Yourigh/BrimEffect_ESP32/README.md

# BrimEffect_ESP32
 ESP32 board with interface for WS2812 LED strip, connected MIC and IR remote receiver, including FW and 3D prited box
 
# 3D prited box
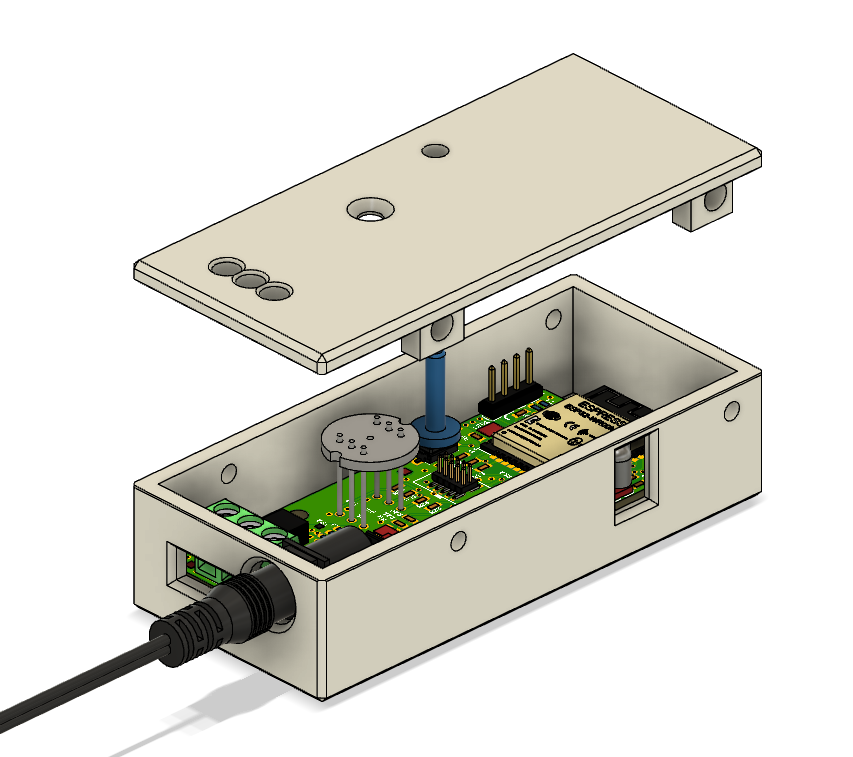
[picture p1: Mechanical/PCBAwBOX.png]
3D model
