Yourigh/BrimEffect_ESP32/Electrical/3 - Gerbers/GerberFiles.png_Combined_Bottom.png

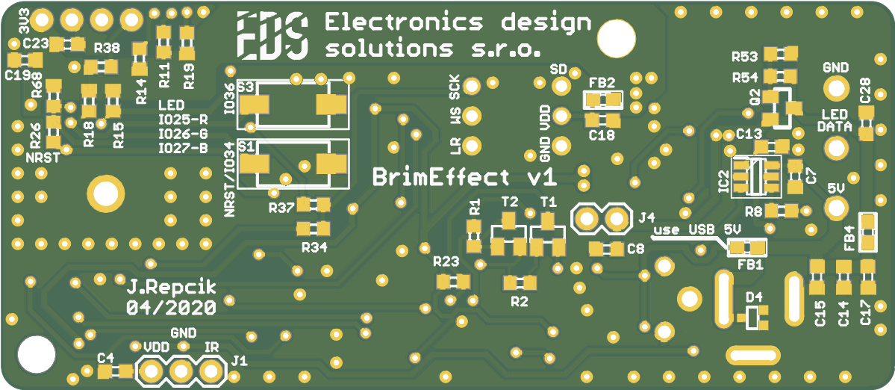
Electrical/3 - Gerbers/GerberFiles.png_Combined_Bottom.png
