Yourigh/BrimEffect_ESP32/Electrical/3 - Gerbers/GerberFiles.png_Combined_Top.png

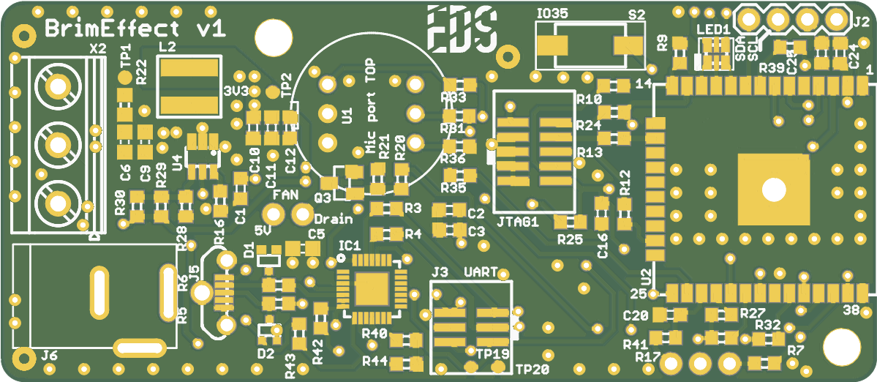
Electrical/3 - Gerbers/GerberFiles.png_Combined_Top.png
