Yourigh/BrimEffect_ESP32/Mechanical/Sub-models/button.webp

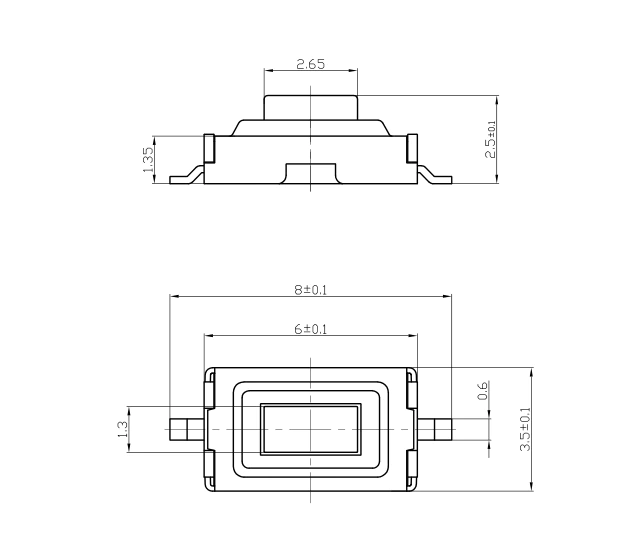
Mechanical/Sub-models/button.webp
