Yourigh/BrimEffect_ESP32/Mechanical/Sub-models/Mic Module INMP441/BOT.png

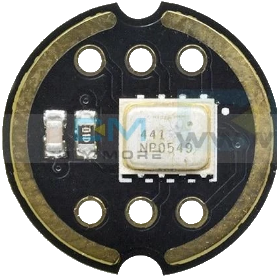
Mechanical/Sub-models/Mic Module INMP441/BOT.png
