Yourigh/BrimEffect_ESP32/Mechanical/Sub-models/Mic Module INMP441/INMP441_module v4.png

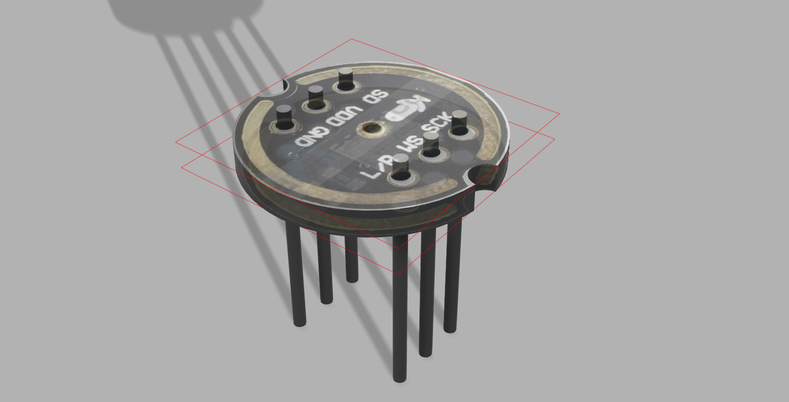
Mechanical/Sub-models/Mic Module INMP441/INMP441_module v4.png
