Yourigh/BrimEffect_ESP32/Mechanical/Sub-models/Mic Module INMP441/Mic_module_dimensions.png

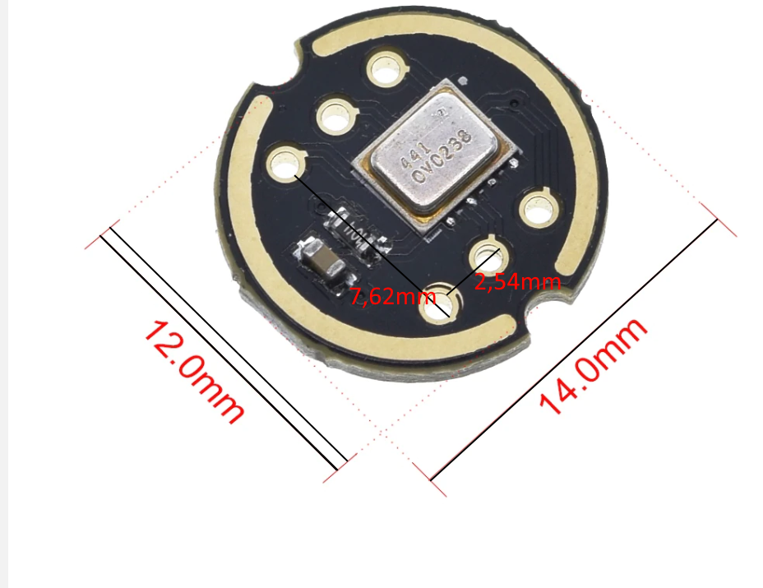
Mechanical/Sub-models/Mic Module INMP441/Mic_module_dimensions.png
