Yourigh/BrimEffect_ESP32/Mechanical/Sub-models/Thread_inserts_M3x4,6used.jpg

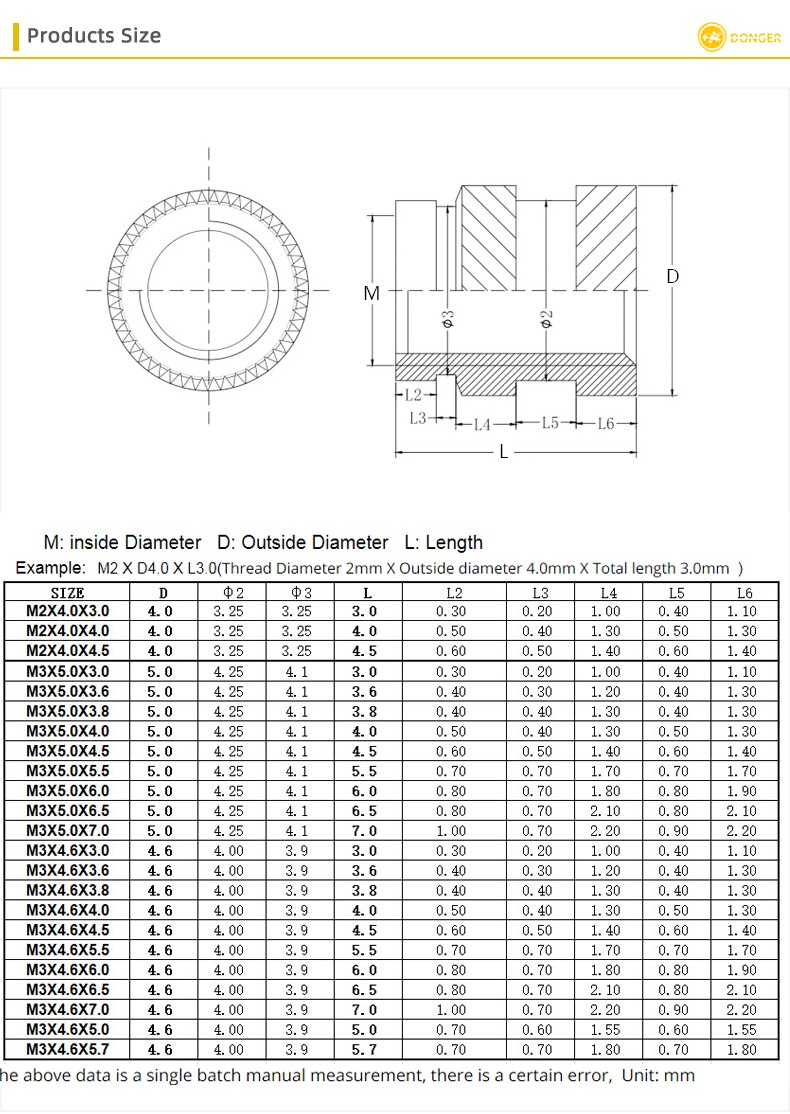
Mechanical/Sub-models/Thread_inserts_M3x4,6used.jpg
