Yourigh/BrimEffect_ESP32/Mechanical/Sub-models/tsop-infrared-receiver-1.snapshot.1/TSOP.jpg

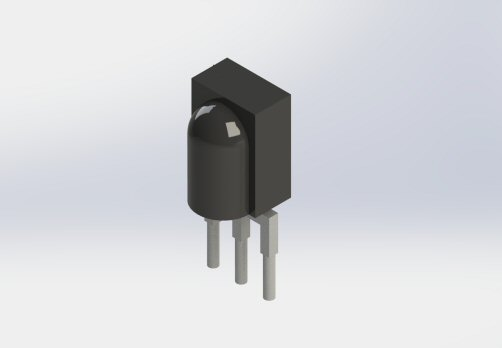
Mechanical/Sub-models/tsop-infrared-receiver-1.snapshot.1/TSOP.jpg
