Yourigh/BrimEffect_ESP32/Mechanical/Sub-models/jtagconn-m50-3610542_asm.stp

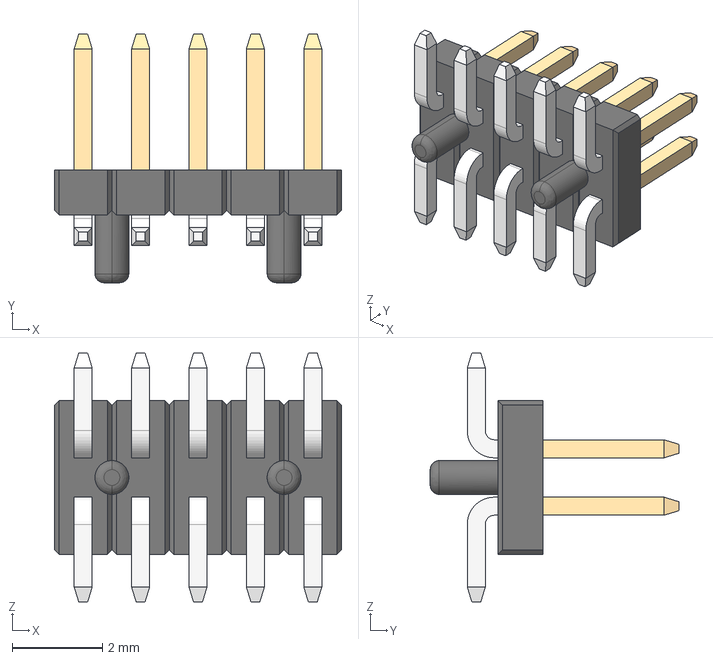
[picture p11: CAD file, 2020-04-05]
Mechanical/Sub-models/jtagconn-m50-3610542_asm.stp
6.35 x 5.50 x 5.50 mm
M50-36105_MOULD
M50-361_CONTACT x 10
