Yourigh/BrimEffect_ESP32/Mechanical/200408_3D_print_export_v22/Box1 v1.stl

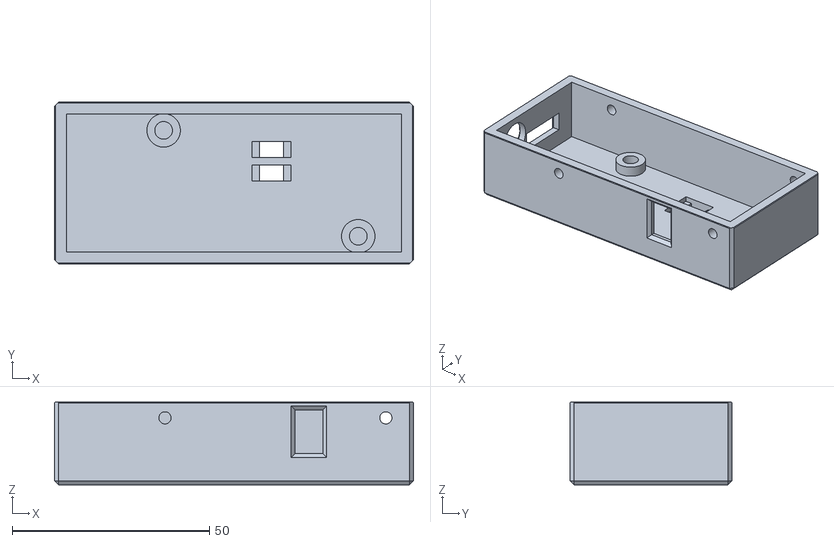
[picture p12: CAD file, 2020-04-08]
Mechanical/200408_3D_print_export_v22/Box1 v1.stl
91.0 x 41.0 x 21.0
