Yourigh/BrimEffect_ESP32/Mechanical/Sub-models/DCJack_5.5x2.1_cable.STEP

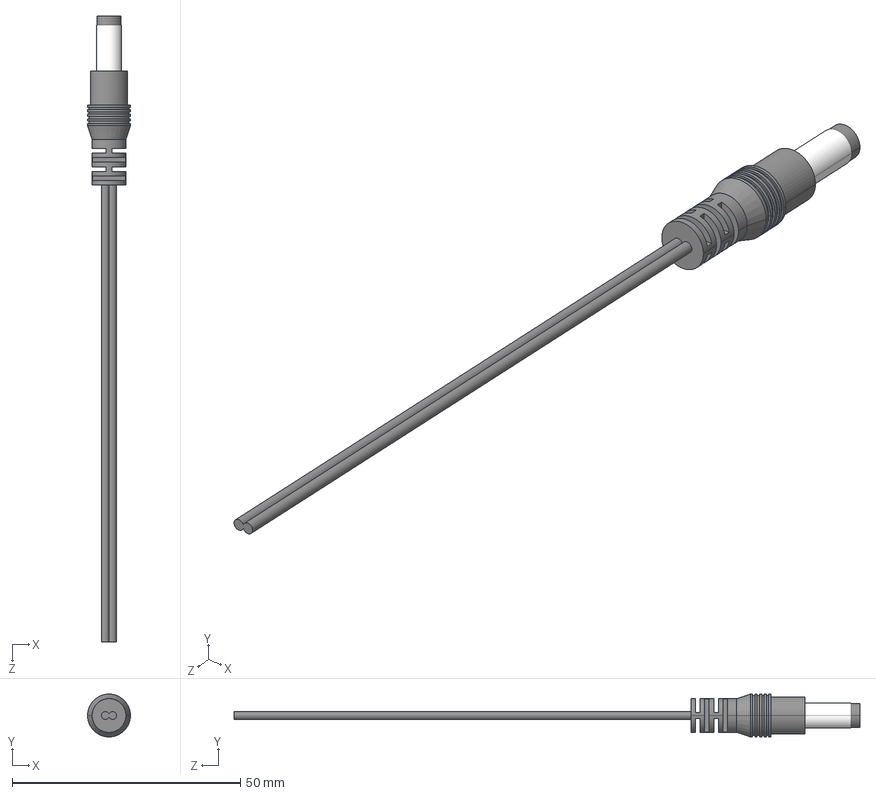
[picture p13: CAD file, 2020-04-07]
Mechanical/Sub-models/DCJack_5.5x2.1_cable.STEP
9.40 x 9.40 x 137.0 mm
