Yourigh/BrimEffect_ESP32/Mechanical/Sub-models/Mic Module INMP441/INMP441_module v4.step

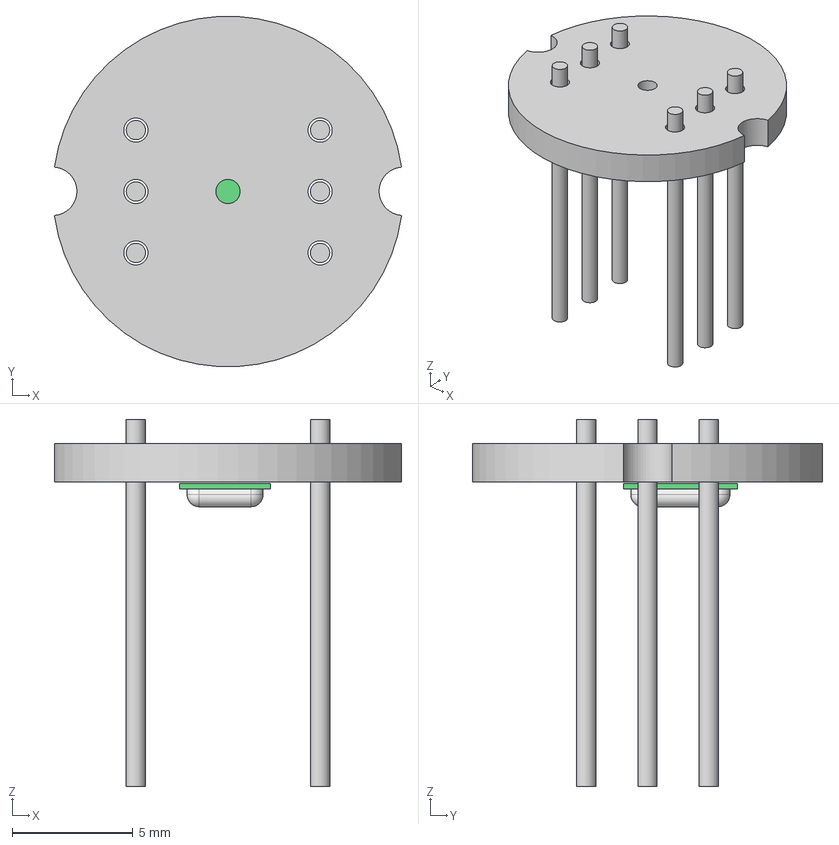
[picture p14: CAD file, 2020-04-24]
Mechanical/Sub-models/Mic Module INMP441/INMP441_module v4.step
14.4 x 14.5 x 15.2 mm
Product
pins
