Yourigh/BrimEffect_ESP32/Mechanical/Sub-models/tsop-infrared-receiver-1.snapshot.1/TSOP.STEP

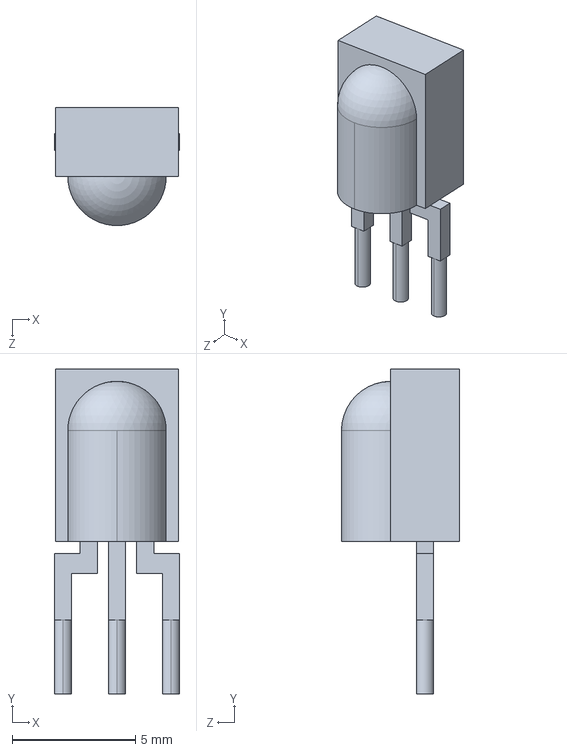
[picture p15: CAD file, 2020-04-05]
Mechanical/Sub-models/tsop-infrared-receiver-1.snapshot.1/TSOP.STEP
5.08 x 13.2 x 4.80 mm
