Yourigh/BrimEffect_ESP32/Mechanical/200408_3D_print_export_v22/Lid v1.stl

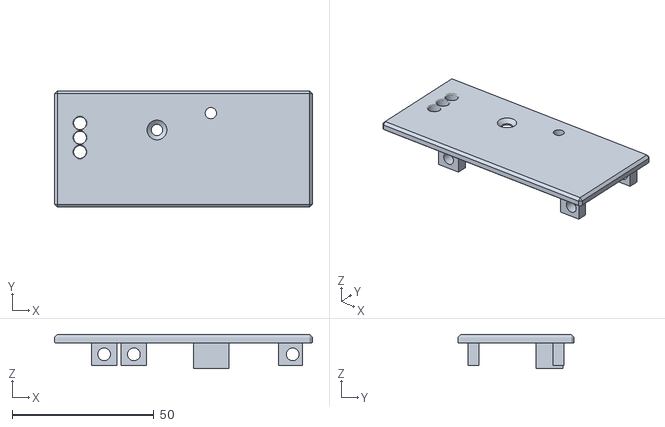
[picture p16: CAD file, 2020-04-08]
Mechanical/200408_3D_print_export_v22/Lid v1.stl
91.0 x 41.0 x 12.0
