Yourigh/BrimEffect_ESP32/Mechanical/Sub-models/pxc_1729131_07_MKDSN-1-5-3-5-08_3D.stp

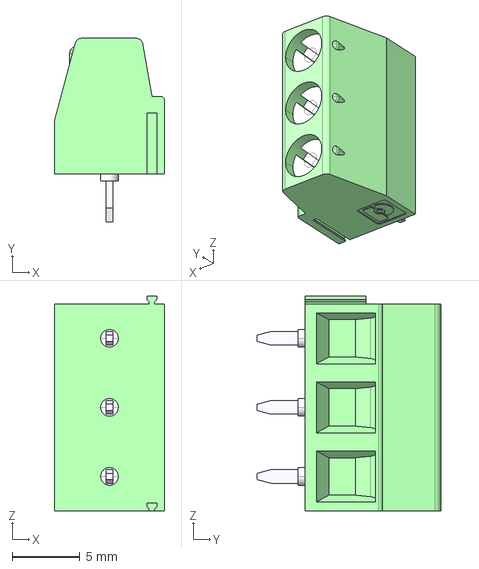
[picture p17: CAD file, 2020-04-05]
Mechanical/Sub-models/pxc_1729131_07_MKDSN-1-5-3-5-08_3D.stp
8.10 x 13.5 x 15.8 mm
