Yourigh/BrimEffect_ESP32/Mechanical/200408_3D_print_export_v22/Btn act top v1.stl

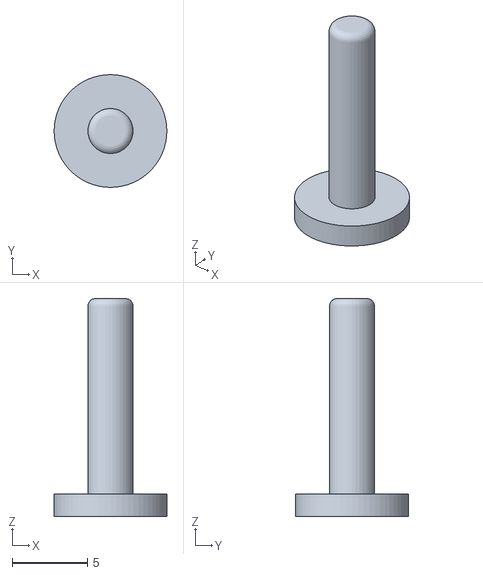
[picture p18: CAD file, 2020-04-08]
Mechanical/200408_3D_print_export_v22/Btn act top v1.stl
7.50 x 7.50 x 14.5
