Yourigh/BrimEffect_ESP32/Mechanical/Sub-models/Mic Module INMP441/mic-INMP441.stp

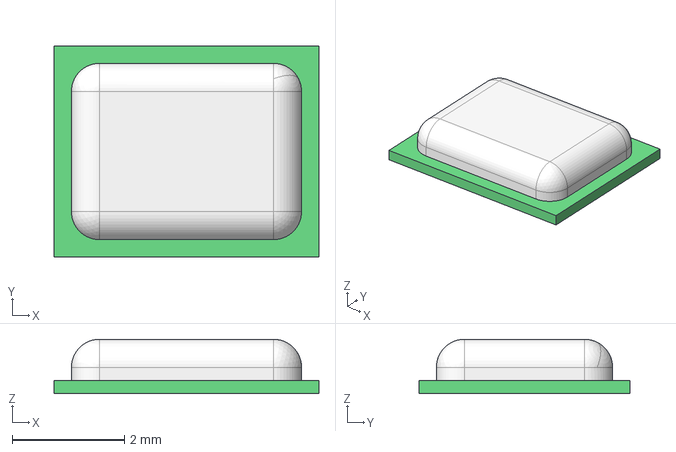
[picture p19: CAD file, 2020-04-05]
Mechanical/Sub-models/Mic Module INMP441/mic-INMP441.stp
4.72 x 3.76 x 0.97 mm
