Yourigh/BrimEffect_ESP32/Mechanical/200408_3D_print_export_v22/2PCS_Button actuator bottom v5.stl

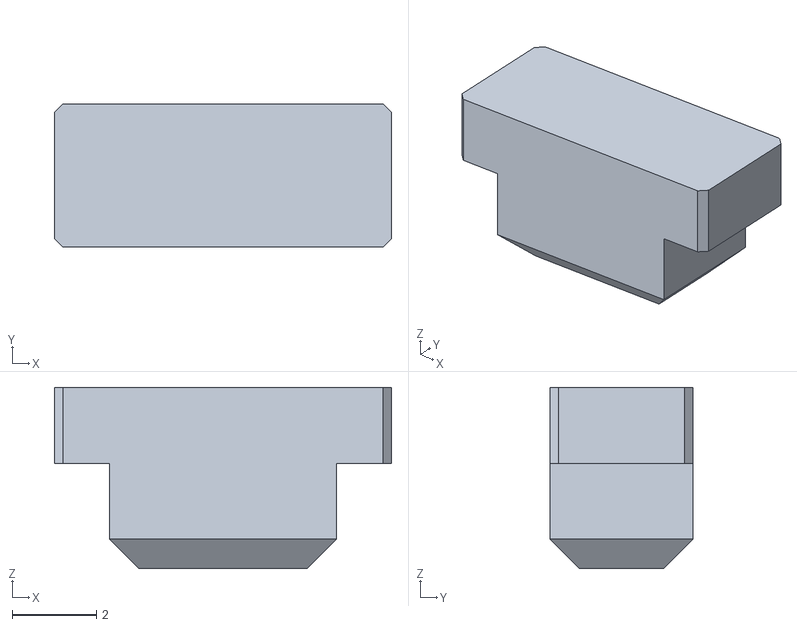
[picture p20: CAD file, 2020-04-08]
Mechanical/200408_3D_print_export_v22/2PCS_Button actuator bottom v5.stl
8.00 x 3.40 x 4.30
