Yourigh/BrimEffect_ESP32/Mechanical/Sub-models/UARTconn-FTSH-103-01-F-DV.stp

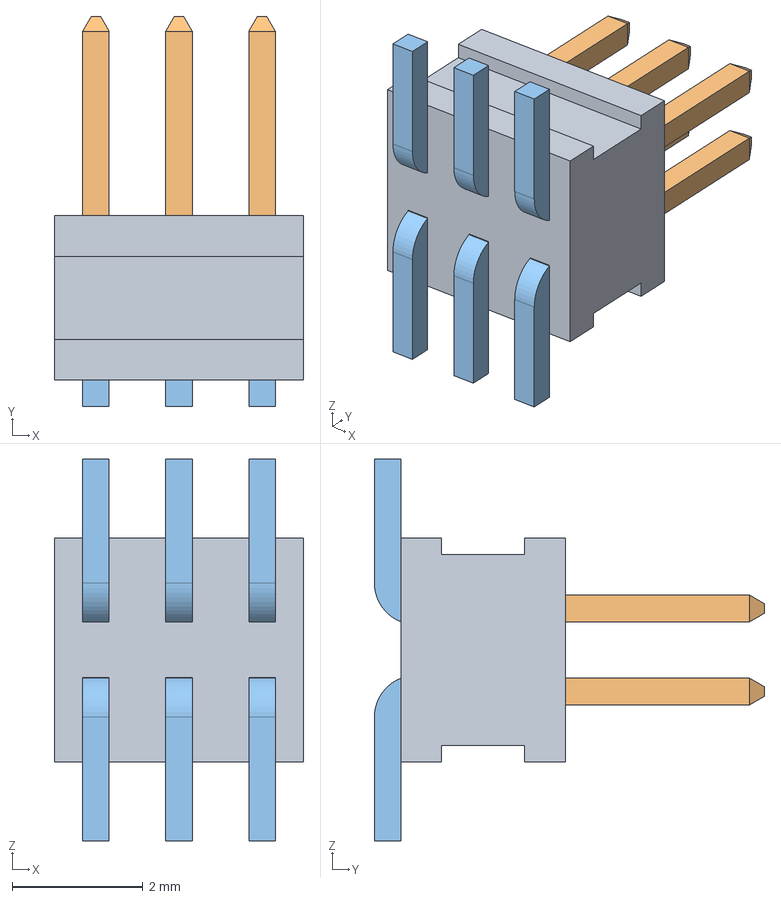
[picture p21: CAD file, 2020-04-05]
Mechanical/Sub-models/UARTconn-FTSH-103-01-F-DV.stp
3.81 x 5.97 x 5.84 mm
_FTSH-103-01-F-DV_body
_FTSH-103-01-F-DV_pins1
_FTSH-103-01-F-DV_pins2
