Yourigh/BrimEffect_ESP32/Mechanical/Sub-models/USB-micro-vert-molex-1051330001.stp

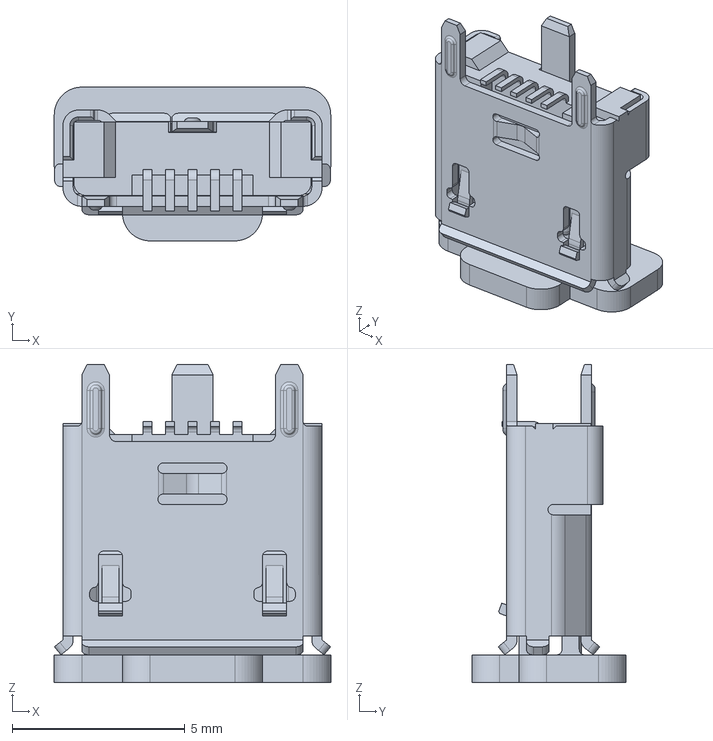
[picture p22: CAD file, 2020-04-05]
Mechanical/Sub-models/USB-micro-vert-molex-1051330001.stp
8.00 x 4.45 x 9.20 mm
