Yourigh/BrimEffect_ESP32/Mechanical/Sub-models/DCjack_CUI_DEVICES_PJ-002A.step

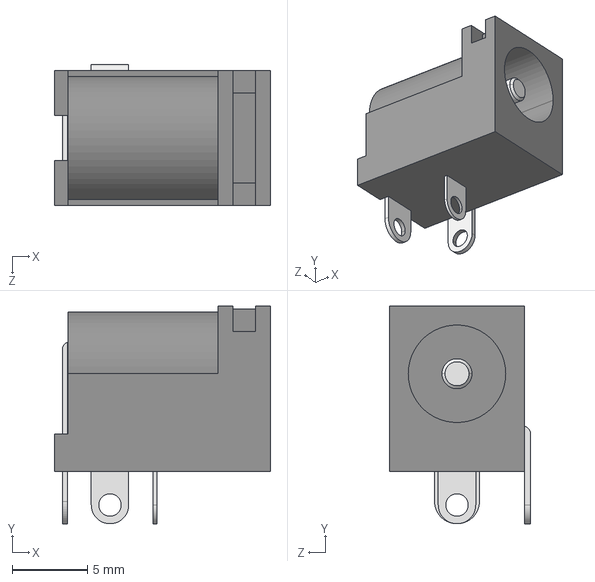
[picture p23: CAD file, 2020-04-05]
Mechanical/Sub-models/DCjack_CUI_DEVICES_PJ-002A.step
14.4 x 14.5 x 9.40 mm
