Yourigh/BrimEffect_ESP32/(list of files, cad)

Other CAD files:
Mechanical/Sub-models/Mic Module INMP441/INMP441_module_rigid v1.step
Mechanical/Sub-models/Mic Module INMP441/INMP441_module v4.f3z
Mechanical/Sub-models/USB-micro-vert-molex-1051330001-e v1.f3d
Mechanical/Sub-models/switch PTS636SK25FSMTRLFS v2.f3d
Mechanical/Sub-models/tsop-infrared-receiver-1.snapshot.1/IR receiver TSOP v2.f3d
Mechanical/Sub-models/tsop-infrared-receiver-1.snapshot.1/TSOP.SLDPRT
