Yourigh/BrimEffect_ESP32/(threads)

Thread 1 (2020-06-26):

An idea

LovelyMengstar, 2020-06-26:
Hello,  you use this project too.(audio-reactive-led-strip)
I think INMP441 costs too much, I want to use SPK 1638Lm4H-B.(https://dtsheet.com/doc/1267573/spk1638lm4h-b)
But I don't know how to draw chematics. Can you help me？Also use esp32.
