Yourigh/BrimEffect_ESP32/Electrical/1 - Schematics/200414_sch.pdf

A

A

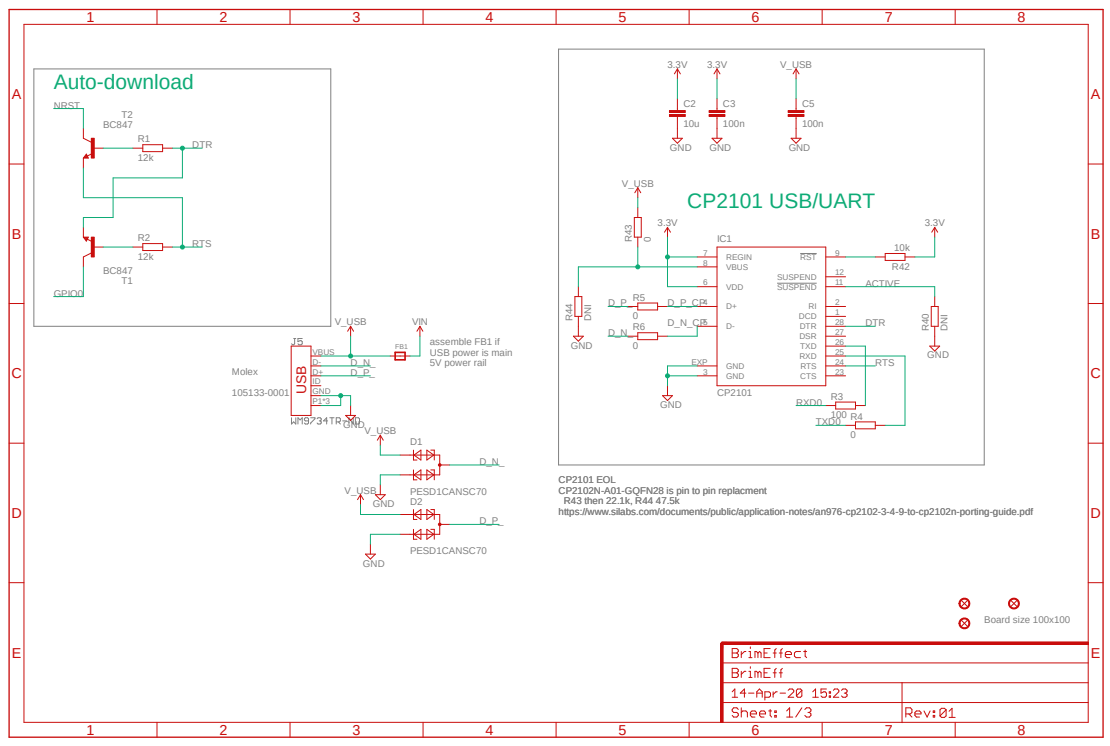
[picture p24: page 1]

VIN
assemble FB1 if
USB power is main
5V power rail

CP2101 EOL
CP2102N-A01-GQFN28 is pin to pin replacment
R43 then 22.1k, R44 47.5k
https://www.silabs.com/documents/public/application-notes/an976-cp2102-3-4-9-to-cp2102n-porting-guide.pdf

# POWER

R22R²⁸ | R²⁹ | R³⁰

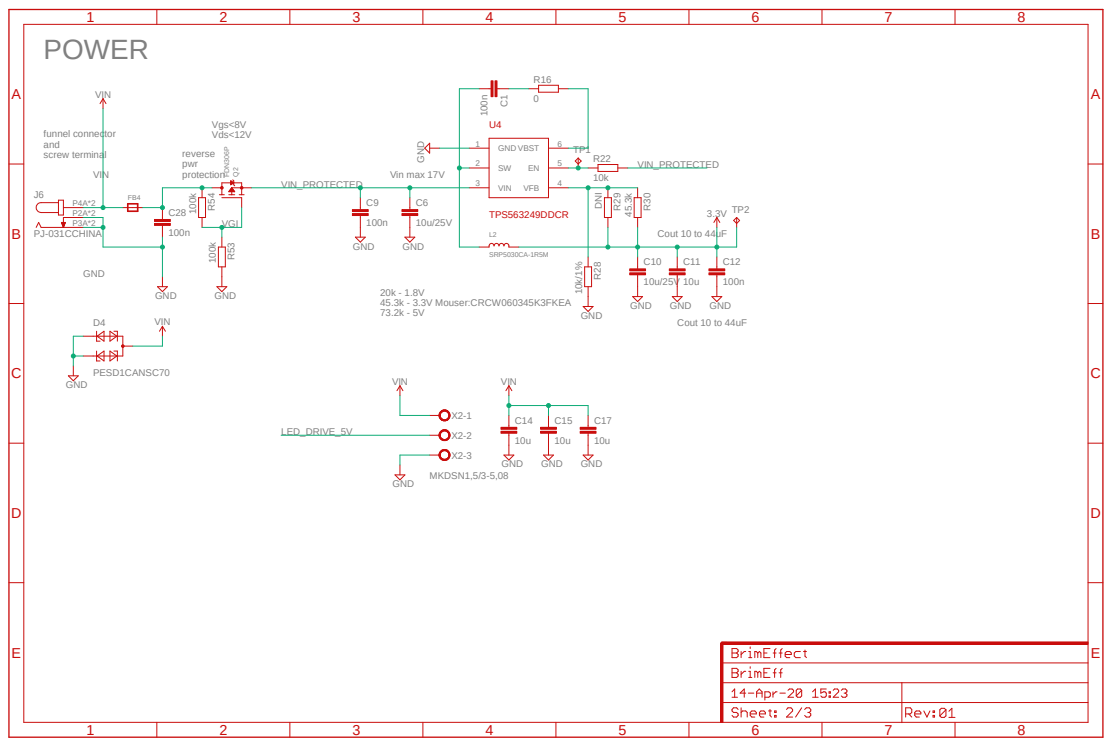
[picture p25: page 2]

A

A

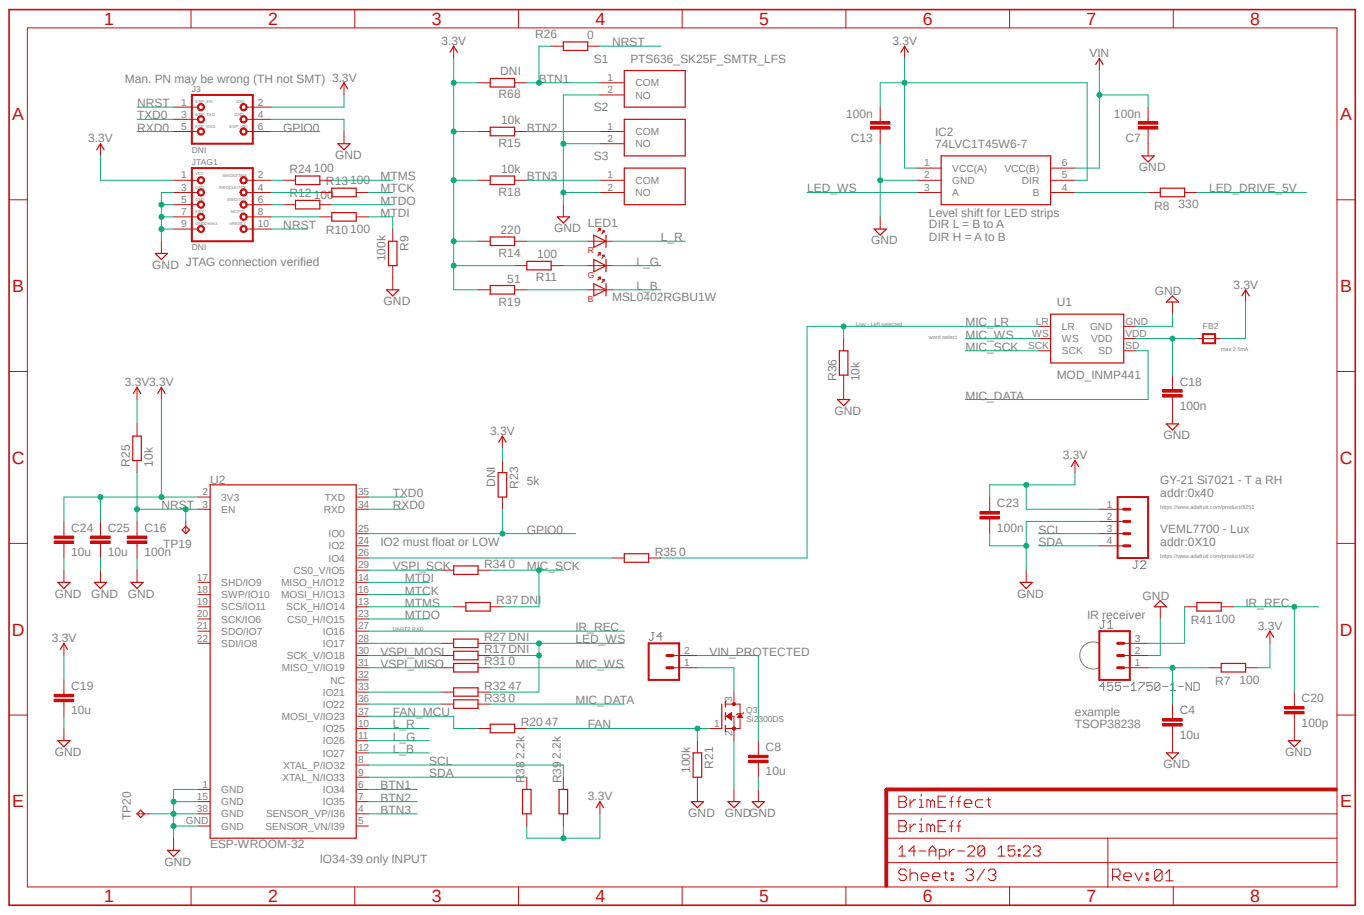
[picture p26: page 3]

Man. PN may be wrong (TH not SMT)
NRST
TXD0
RXD0

https://www.adafruit.com/product/3251 GY-21 Si7021 - T a RH
addr:0x40

https://www.adafruit.com/product/4162
