Yourigh/BrimEffect_ESP32/Electrical/5 - CAD project/BrimEff.brd

## EAGLE design Electrical/5 - CAD project/BrimEff.brd (2020-06-14)

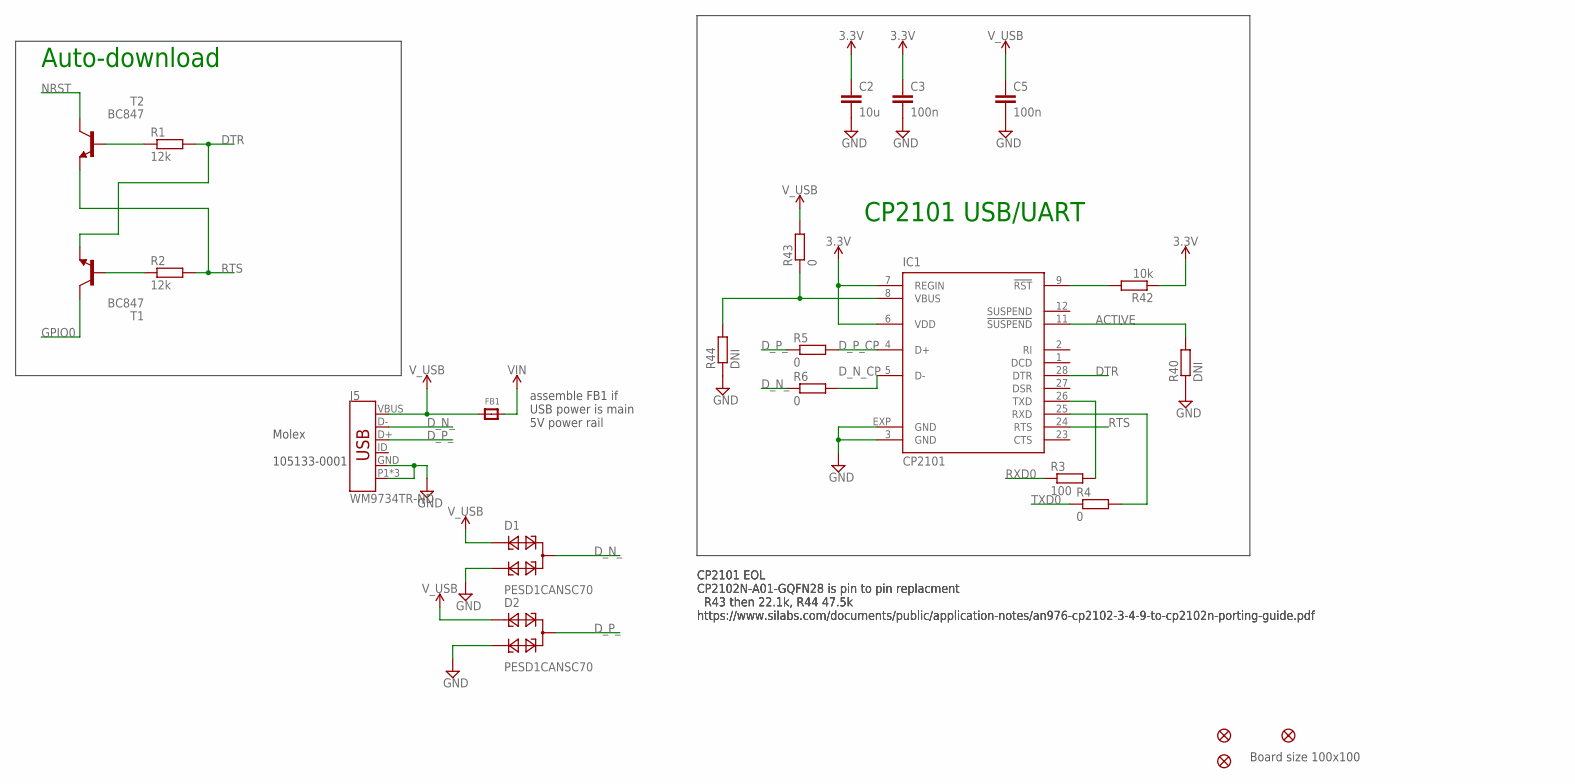
[picture p27: schematic BrimEff.sch, sheet 1]

Parts:
C2: 10u; C0603K; PARTNO GRM188R61A106KE69J
C3, C5: 100n; C0603K; PARTNO CC0603KRX7R8BB104
D1, D2: PESD1CANSC70; SOT323-R; PARTNO PESD1CAN-UX
FB1: FERRITE; 0603; PARTNO BLM18PG121SN1D
FID1, FID2, FID4: FIDUCIAL""; FIDUCIAL_1MM
IC1: CP2101; MLP28; PARTNO CP2101-GM
J5: WM9734TR-ND; USB-B-MICRO-SMD_VERT; PARTNO 105133-0001
R1, R2: 12k; R0603; PARTNO RC0603FR-0712KL
R3: 100; R0603; PARTNO CRCW0603100RFKEAC
R4, R5, R6, R43: 0; R0603; PARTNO CRCW06030000Z0EAC
R40, R44: DNI; R0603; PARTNO CRCW06030000Z0EAC
R42: 10k; R0603; PARTNO CRCW060310K0JNEAC
T1, T2: BC847; SOT23; PARTNO BC847A-TP

Connections:
3.3V: C2.1, C3.1, IC1.6 (VDD), IC1.7 (REGIN), R42.1; also elsewhere on the board
ACTIVE: IC1.11 (!SUSPEND), R40.2
DTR: IC1.28 (DTR), R1.2, T1.2 (E)
D_N_: D1.3, J5.D-, R6.1
D_N_CP: IC1.5 (D-), R6.2
D_P_: D2.3, J5.D+, R5.1
D_P_CP: IC1.4 (D+), R5.2
GND: C2.2, C3.2, C5.2, D1.2, D2.2, IC1.3 (GND), IC1.EXP (GND), J5.GND, J5.P1 (SHIELD), J5.P2 (SHIELD), J5.P3 (SHIELD), R40.1, R44.1; also elsewhere on the board
GPIO0: T1.3 (C); also elsewhere on the board
unnamed: R1.1, T2.1 (B)
unnamed: R2.1, T1.1 (B)
unnamed: IC1.9 (!RST), R42.2
unnamed: IC1.8 (VBUS), R43.1, R44.2
NRST: T2.3 (C); also elsewhere on the board
RTS: IC1.24 (RTS), R2.2, T2.2 (E)
RXD0: R3.1; also elsewhere on the board
RXD0_CP2101IN: IC1.26 (TXD), R3.2
TXD0: R4.1; also elsewhere on the board
TXD0_CP2101: IC1.25 (RXD), R4.2
VIN: FB1.2; also elsewhere on the board
V_USB: C5.1, D1.1, D2.1, FB1.1, J5.VBUS, R43.2

Notes on the sheet:
CP2101 USB/UART
Auto-download
Board size 100x100
Molex 105133-0001
CP2101 EOL CP2102N-A01-GQFN28 is pin to pin replacment R43 then 22.1k, R44 47.5k https://www.silabs.com/documents/public/application-notes/an976-cp2102-3-4-9-to-cp2102n-porting-guide.pdf
assemble FB1 if USB power is main 5V power rail

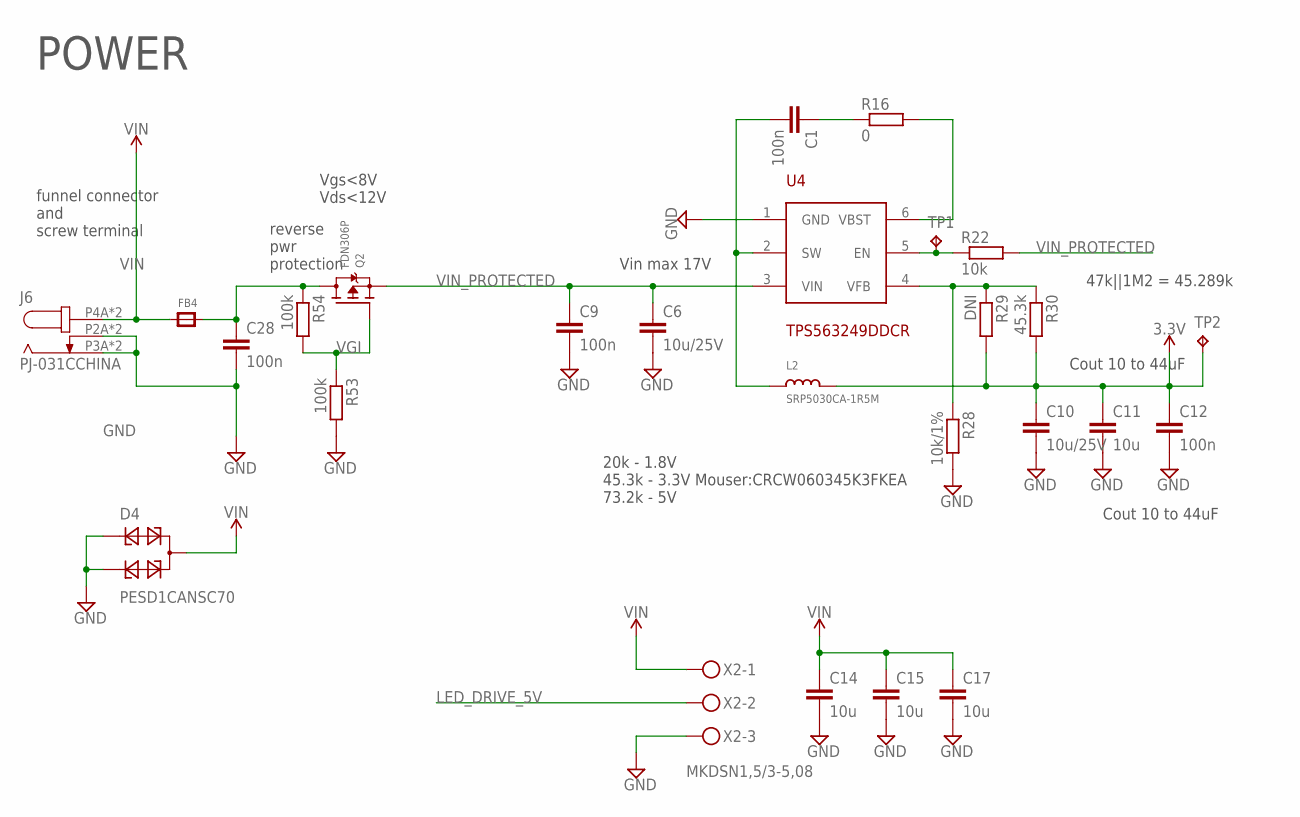
[picture p28: schematic BrimEff.sch, sheet 2]

Parts:
C1, C9, C12, C28: 100n; C0603K; PARTNO CC0603KRX7R8BB104
C6, C10: 10u/25V; C0603K; PARTNO GRM188R61E106KA73J
C11, C14, C15, C17: 10u; C0603K; PARTNO GRM188R61A106KE69J
D4: PESD1CANSC70; SOT323-R; PARTNO PESD1CAN-UX
FB4: FERRITE; 0603; PARTNO BLM18PG121SN1D
J6: PJ-031CCHINA; DC-005_5.5X2.1MM_JACK
L2: SRP5030CA-1R5M; SRP5030CA; PARTNO SRP5030CA-1R5M
Q2: FDN306P; SOT23-WIDE; PARTNO FDN306P
R16: 0; R0603; PARTNO CRCW06030000Z0EAC
R22: 10k; R0603; PARTNO CRCW060310K0JNEAC
R28: 10k/1%; R0603; PARTNO RN73R1JTTD1002D25
R29: DNI; R0603
R30: 45.3k; R0603; PARTNO ERJ-PB3D4532V
R53, R54: 100k; R0603; PARTNO CRCW0603100KFKEAC
TP1, TP2: TPTP10R; TP10R
U4: TPS563249DDCR; SOT23-6; PARTNO TPS563249DDCR
X2: MKDSN1,5/3-5,08

Connections:
3.3V: C10.1, C11.1, C12.1, L2.P$2 (2), R29.2, R30.2, TP2.TP; also elsewhere on the board
GND: C6.2, C9.2, C10.2, C11.2, C12.2, C14.2, C15.2, C17.2, C28.2, D4.1, D4.2, J6.P2A (3), J6.P2B (3), J6.P3A (2), J6.P3B (2), R28.2, R53.2, U4.1 (GND), X2.3; also elsewhere on the board
LED_DRIVE_5V: X2.2; also elsewhere on the board
unnamed: C1.1, R16.1
unnamed: C28.1, FB4.2, Q2.3 (D), R54.1
unnamed: R16.2, U4.6 (VBST)
unnamed: C1.2, L2.P$1 (1), U4.2 (SW)
unnamed: R22.1, TP1.TP, U4.5 (EN)
unnamed: R28.1, R29.1, R30.1, U4.4 (VFB)
VGI: Q2.1 (G), R53.1, R54.2
VIN: C14.1, C15.1, C17.1, D4.3, FB4.1, J6.P4A (1), J6.P4B (1), X2.1; also elsewhere on the board
VIN_PROTECTED: C6.1, C9.1, Q2.2 (S), R22.2, U4.3 (VIN); also elsewhere on the board

Notes on the sheet:
POWER
20k - 1.8V 45.3k - 3.3V Mouser:CRCW060345K3FKEA 73.2k - 5V
Cout 10 to 44uF
reverse pwr protection
Vgs<8V Vds<12V
Vin max 17V
funnel connector and screw terminal
47k||1M2 = 45.289k

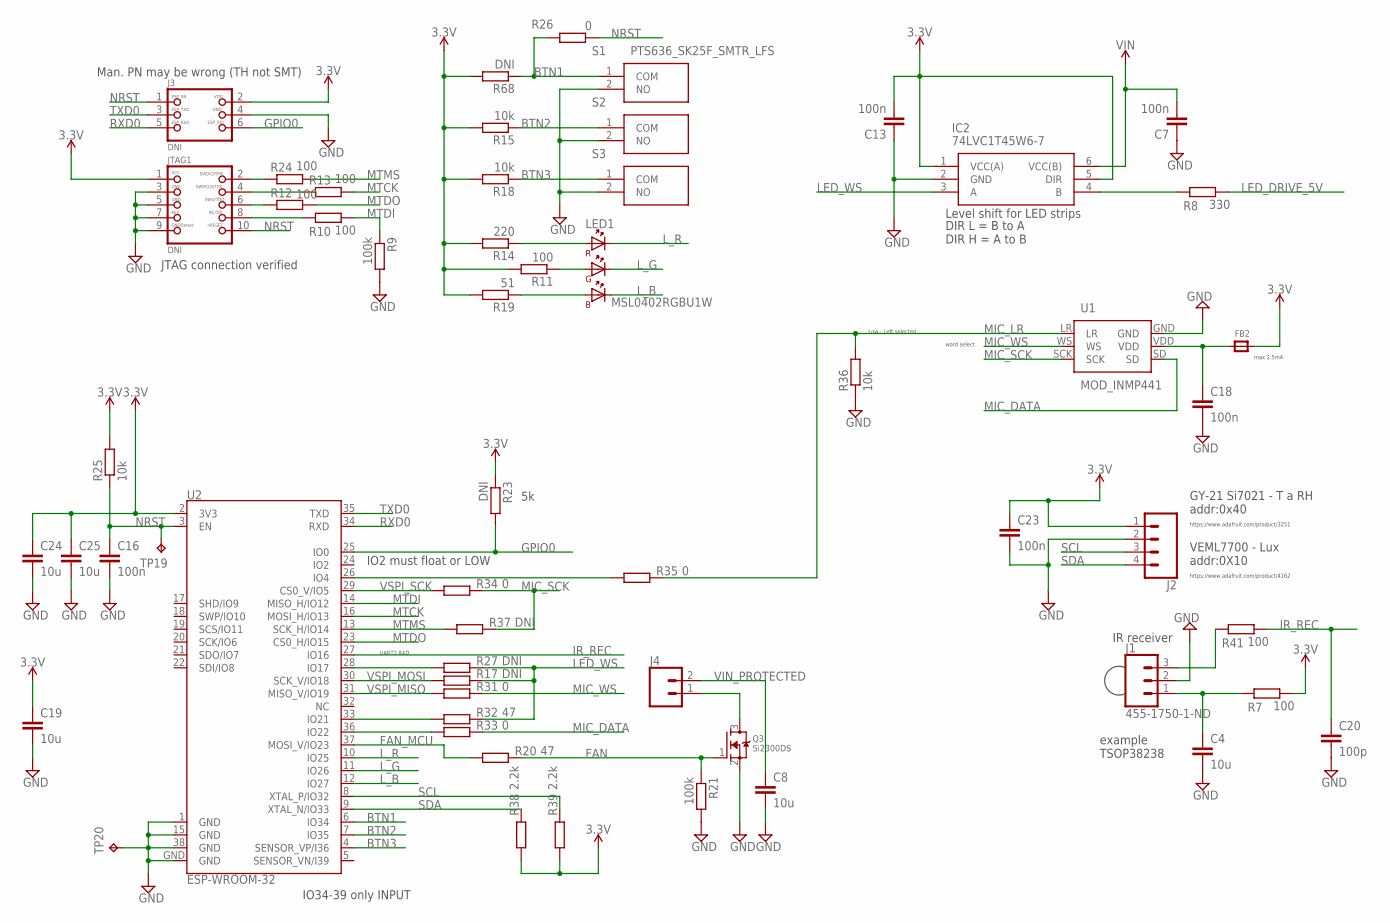
[picture p29: schematic BrimEff.sch, sheet 3]

Parts:
C4, C8, C19, C24, C25: 10u; C0603K; PARTNO GRM188R61A106KE69J
C7, C13, C16, C18, C23: 100n; C0603K; PARTNO CC0603KRX7R8BB104
C20: 100p; C0603K; PARTNO GRM188R61A106KE69J
FB2: FERRITE; 0603; PARTNO BLM18PG121SN1D
IC2: 74LVC1T45W6-7; SOT95P285X140-6N
J1: 455-1750-1-ND; 1X03
J2: CONN_04PTH; 1X04
J3: DNI; 2X03_1.27MM_SMT; PARTNO HTMS-103-03-T-D-SM
J4: CONN_02; 1X02
JTAG1: DNI; 2X05_1.27MM_SMT; PARTNO M50-3600542R
LED1: MSL0402RGBU1W; MSL0402RGBU1-W
Q3: Si2300DS; SOT23; PARTNO SI2300DS-T1-GE3
R7, R10, R11, R12, R13, R24, R41: 100; R0603; PARTNO CRCW0603100RFKEAC
R8: 330; R0603; PARTNO CRCW0603100RFKEAC
R9, R21: 100k; R0603; PARTNO CRCW0603100KFKEAC
R14: 220; R0603; PARTNO CRCW0603100RFKEAC
R15, R18, R25, R36: 10k; R0603; PARTNO CRCW060310K0JNEAC
R17, R27, R37: DNI; R0603; PARTNO CRCW060347R0FKEAC
R19: 51; R0603; PARTNO CRCW0603100RFKEAC
R20, R32: 47; R0603; PARTNO CRCW060347R0FKEAC
R23: DNI; R0603; PARTNO CRCW06030000Z0EAC
R26: 0; R0603; PARTNO CRCW060310K0JNEAC
R31, R33, R34, R35: 0; R0603; PARTNO CRCW060347R0FKEAC
R38, R39: 2.2k; R0603; PARTNO CRCW060347R0FKEAC
R68: DNI; R0603; PARTNO CRCW060310K0JNEAC
S1, S2, S3: PTS636_SK25F_SMTR_LFS; PTS636SK25FSMTRLFS
TP19, TP20: TPTP10R; TP10R
U1: MOD_INMP441
U2: ESP-WROOM-32; PARTNO ESP32-WROOM-32

Connections:
3.3V: C13.2, C19.1, C23.1, C24.1, C25.1, FB2.2, IC2.1 (VCC(A)), IC2.5 (DIR), J2.1, J3.2, JTAG1.1, R7.2, R11.2, R14.2, R15.2, R18.2, R19.2, R23.1, R25.2, R38.1, R39.1, R68.2, U2.2 (3V3); also elsewhere on the board
BTN1: R26.2, R68.1, S1.1 (COM), U2.6 (IO34)
BTN2: R15.1, S2.1 (COM), U2.7 (IO35)
BTN3: R18.1, S3.1 (COM), U2.4 (SENSOR_VP/I36)
FAN: Q3.1 (G), R20.2, R21.1
FAN_MCU: R20.1, U2.37 (MOSI_V/IO23)
GND: C4.2, C7.1, C8.2, C13.1, C16.2, C18.2, C19.2, C20.2, C23.2, C24.2, C25.2, IC2.2 (GND), J1.2, J2.2, J3.4, JTAG1.3, JTAG1.5, JTAG1.7, JTAG1.9, Q3.2 (S), R9.2, R21.2, R36.1, S1.2 (NO), S2.2 (NO), S3.2 (NO), TP20.TP, U1.GND, U2.1 (GND), U2.15 (GND), U2.38 (GND), U2.GND; also elsewhere on the board
GPIO0: J3.6, R23.2, U2.25 (IO0); also elsewhere on the board
IR_REC: C20.1, R41.2, U2.27 (IO16)
LED_DRIVE_5V: R8.2; also elsewhere on the board
LED_WS: IC2.3 (A), R17.2, R27.2, R32.2
L_B: LED1.1 (K_B), U2.12 (IO27)
L_G: LED1.2 (K_G), U2.11 (IO26)
L_R: LED1.3 (K_R), U2.10 (IO25)
MIC_DATA: R33.2, U1.SD
MIC_LR: R35.2, R36.2, U1.LR
MIC_SCK: R34.2, R37.2, U1.SCK
MIC_WS: R31.2, U1.WS
MTCK: R13.2, U2.16 (MOSI_H/IO13)
MTDI: R9.1, R10.2, U2.14 (MISO_H/IO12)
MTDO: R12.2, U2.23 (CS0_H/IO15)
MTMS: R24.2, R37.1, U2.13 (SCK_H/IO14)
unnamed: J1.3, R41.1
unnamed: LED1.6 (A_B), R19.1
unnamed: J4.1, Q3.3 (D)
unnamed: C4.1, J1.1, R7.1
unnamed: IC2.4 (B), R8.1
unnamed: LED1.5 (A_G), R11.1
unnamed: C18.1, FB2.1, U1.VDD
unnamed: R27.1, U2.28 (IO17)
unnamed: R32.1, U2.33 (IO21)
unnamed: LED1.4 (A_R), R14.1
unnamed: R33.1, U2.36 (IO22)
unnamed: R35.1, U2.26 (IO4)
NRST: C16.1, J3.1, JTAG1.10, R25.1, R26.1, TP19.TP, U2.3 (EN); also elsewhere on the board
RXD0: J3.5, U2.34 (RXD); also elsewhere on the board
SCL: J2.3, R39.2, U2.8 (XTAL_P/IO32)
SDA: J2.4, R38.2, U2.9 (XTAL_N/IO33)
TCKCONN: JTAG1.4, R13.1
TDICONN: JTAG1.8, R10.1
TDOCONN: JTAG1.6, R12.1
TMSCONN: JTAG1.2, R24.1
TXD0: J3.3, U2.35 (TXD); also elsewhere on the board
VIN: C7.2, IC2.6 (VCC(B)); also elsewhere on the board
VIN_PROTECTED: C8.1, J4.2; also elsewhere on the board
VSPI_MISO: R31.1, U2.31 (MISO_V/IO19)
VSPI_MOSI: R17.1, U2.30 (SCK_V/IO18)
VSPI_SCK: R34.1, U2.29 (CS0_V/IO5)

Notes on the sheet:
JTAG connection verified
IO34-39 only INPUT
IO2 must float or LOW
Man. PN may be wrong (TH not SMT)
VEML7700 - Lux addr:0X10
https://www.adafruit.com/product/4162
https://www.adafruit.com/product/3251
GY-21 Si7021 - T a RH addr:0x40
Level shift for LED strips
IR receiver
example TSOP38238
DIR L = B to A DIR H = A to B
word select
UART2 RXD
max 2.5mA
Low - Left selected

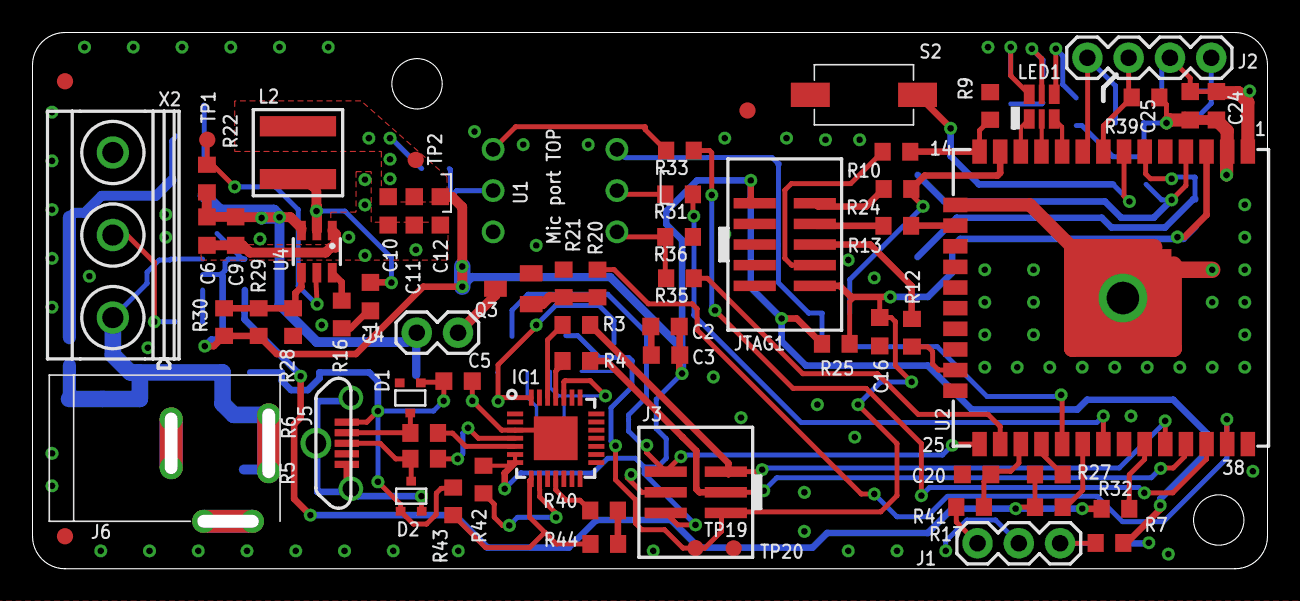
[picture p30: board BrimEff.brd from above]

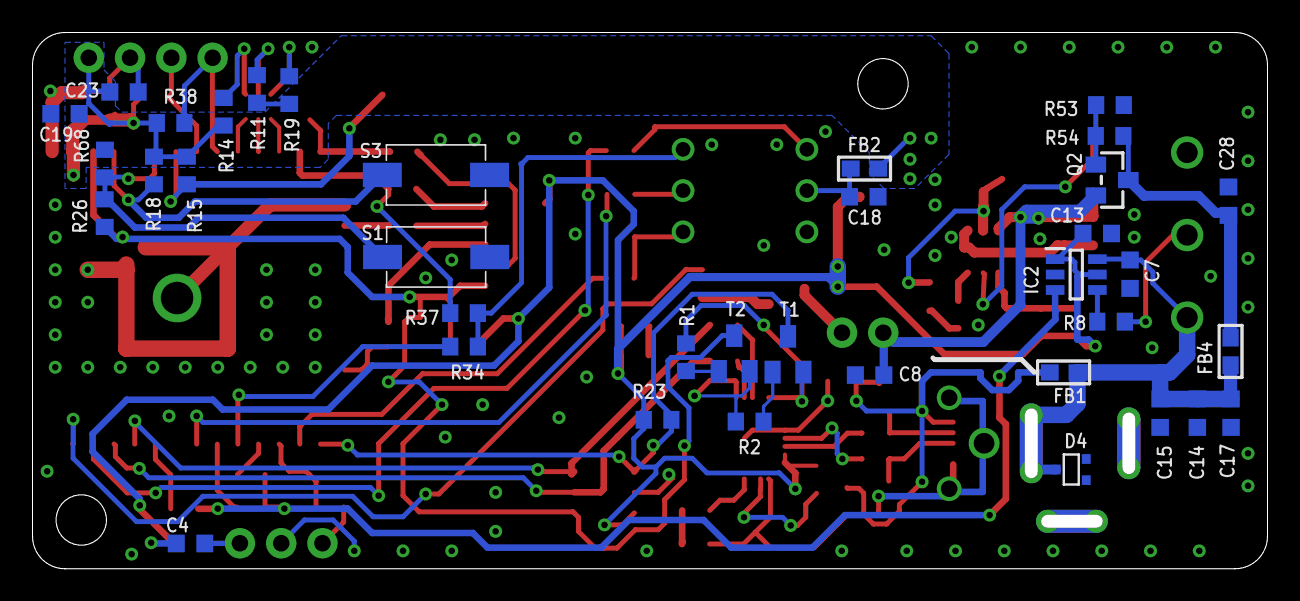
[picture p31: board BrimEff.brd from below]

Board: 2 copper layers, 76.0 x 33.0 mm, 106 parts (37 on the bottom side), 69 nets.
