Yourigh/BrimEffect_ESP32/FW/audio-reactive-led-strip/audio-reactive-led-strip.ino

/* The main program of 
 *
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
 */

#include "driver/i2s.h"
#include <FastLED.h>
#include "includes/FFT.h"
#include "includes/VisualEffect.h"

/* Some viriables in programs
*
* BUFFER_SIZE: How many samples to be received each time. This number must be the power of 2.
* const uint16_t BUFFER_SIZE = 1024;
*
* N_ROLLING_HISTORY: How many buffers to be processed each time. This number must be the power of 2: 1,2,4,8,...
* const uint8_t N_ROLLING_HISTORY = 2;
*
* SAMPLE_RATE: The sample rate of the audio every second.
* const uint16_t SAMPLE_RATE = 44100;
*
* N_PIXELS: The number of the LEDS on the led strip, it must be even.
* const uint16_t N_PIXELS = 60;
*
* N_MEL_BIN: The number of the channels of the mel frequency.
* const uint16_t N_MEL_BIN = 18;
*
* MIN_FREQUENCY, MAX_FREQUENCY: The audio's min/max frequency to be processed. The max frequency always less than SAMPLE_RATE/2
* const float MIN_FREQUENCY = 200;
* const float MAX_FREQUENCY = 12000;
*
* MIN_VOLUME_THRESHOLD: If the audio's volume is less than this number, the signal will not be processed.
* const float MIN_VOLUME_THRESHOLD = 0.0003;
*
* PDM_WS_IO_PIN, PDM_DATA_IN_PIN: Microphone(type of PDM)'s WS Pin and DATA_IN Pin, connecting to GPIO
* const int PDM_WS_IO_PIN = 19;
* const int PDM_DATA_IN_PIN = 22;
*
* LED_STRIP_DATA_PIN, LED_STRIP_CLOCK_PIN: Led-strip's data pin and clock pin, connecting to GPIO
* If you use a led-strip with clock pin, you should modify the FastLED.addLeds calling in programs.
* const int LED_STRIP_DATA_PIN = 21;
* const int LED_STRIP_CLOCK_PIN = 17;
*
* TOUCH_PAD_PIN: TOUCH PAD's number. TOUCH_PAD_NUM9 is GPIO32. https://github.com/espressif/arduino-esp32/blob/master/tools/sdk/include/driver/driver/touch_pad.h
* const touch_pad_t TOUCH_PAD_PIN = TOUCH_PAD_NUM9;
*
*/

const uint16_t BUFFER_SIZE = 1024;
const uint8_t N_ROLLING_HISTORY = 2;
const uint16_t SAMPLE_RATE = 44100;
const uint16_t N_PIXELS =  10; //240;//59 - table set;
const uint16_t N_MEL_BIN = 18;
const float MIN_FREQUENCY = 200;
const float MAX_FREQUENCY = 12000;
const float MIN_VOLUME_THRESHOLD = 0.0003;

const int PDM_WS_IO_PIN = 19;
const int PDM_CLK_IO_PIN = 5;
const int PDM_DATA_IN_PIN = 22;

#define I2S_WS 19
#define I2S_SD 22
#define I2S_SCK 5

const int LED_STRIP_DATA_PIN = 21;
const int LED_STRIP_CLOCK_PIN = 17;
const touch_pad_t TOUCH_PAD_PIN = TOUCH_PAD_NUM9; /*TOUCH_PAD_NUM9 is GPIO32*/

float y_data[BUFFER_SIZE * N_ROLLING_HISTORY];
class FFT fft(BUFFER_SIZE*N_ROLLING_HISTORY, N_MEL_BIN, MIN_FREQUENCY, MAX_FREQUENCY, SAMPLE_RATE, MIN_VOLUME_THRESHOLD);
class VisualEffect effect(N_MEL_BIN, N_PIXELS);
CRGB physic_leds[N_PIXELS];

i2s_config_t i2s_config = {
  .mode = (i2s_mode_t)(I2S_MODE_MASTER | I2S_MODE_RX),// | I2S_MODE_PDM),
  .sample_rate = SAMPLE_RATE,
  .bits_per_sample = i2s_bits_per_sample_t(16), //I2S_BITS_PER_SAMPLE_16BIT,
  .channel_format = I2S_CHANNEL_FMT_ONLY_LEFT,//was RIGHT, but when L/R is L - it is left channel
  .communication_format = i2s_comm_format_t(I2S_COMM_FORMAT_I2S | I2S_COMM_FORMAT_I2S_MSB), //I2S_COMM_FORMAT_PCM,

  .intr_alloc_flags = ESP_INTR_FLAG_LEVEL1,
  .dma_buf_count = 32,
  .dma_buf_len = 32
};

i2s_pin_config_t pin_config = {
  .bck_io_num = PDM_CLK_IO_PIN,// was -1
  .ws_io_num = PDM_WS_IO_PIN,
  .data_out_num = -1,
  .data_in_num = PDM_DATA_IN_PIN
};


typedef enum PLAYMODE {
  MODE_OFF = 0,
  MODE_ON = 1,
  MODE_RAINBOW = 2,
  MODE_SCROLL = 3,
  MODE_ENERGY = 4,
  MODE_SPECTRUM = 5,
  MODE_MAX
};
PLAYMODE CurrentMode = MODE_OFF;//MODE_SCROLL;

void setup() {
  //LEDs
  pinMode(35,INPUT); //BTN
  pinMode(25,OUTPUT);
  pinMode(26,OUTPUT);
  pinMode(27,OUTPUT);
  delay(1000);
  Serial.println("\nLED on");
  digitalWrite(25,LOW); //ON
  digitalWrite(26,LOW);
  digitalWrite(27,LOW);
  delay(1000);
  digitalWrite(25,HIGH); //OFF
  digitalWrite(26,HIGH);
  digitalWrite(27,HIGH);
  Serial.println("\nLED off");

  
  FastLED.addLeds<NEOPIXEL, LED_STRIP_DATA_PIN>(physic_leds, N_PIXELS);
  //FastLED.addLeds<APA102, LED_STRIP_DATA_PIN, LED_STRIP_CLOCK_PIN, GRB>(physic_leds, N_PIXELS);
  Serial.begin(115200);
  i2s_driver_install(I2S_NUM_0, &i2s_config, 0, NULL); 
  i2s_set_pin(I2S_NUM_0, &pin_config); // try changing to i2s_set_pin(I2S_PORT, &pin_config);
  i2s_stop(I2S_NUM_0);
  i2s_start(I2S_NUM_0);
}

void loop() {
  static float mel_data[N_MEL_BIN];

  for (int i = 0; i < N_ROLLING_HISTORY - 1; i++)
    memcpy(y_data + i * BUFFER_SIZE, y_data + (i + 1)*BUFFER_SIZE, sizeof(float)*BUFFER_SIZE);

  int16_t l[BUFFER_SIZE];

  unsigned int read_num;
  i2s_read(I2S_NUM_0, l, BUFFER_SIZE * 2, &read_num, portMAX_DELAY);

  for (int i = 0; i < BUFFER_SIZE; i++) {
    y_data[BUFFER_SIZE * (N_ROLLING_HISTORY - 1) + i] = l[i] / 32768.0;

    /*
    * This should output the current time(in millisececonds) every second.
    * The output frequency larger than one second greatly, means the CPU is overload.
    *
    * static uint32_t ii = 0;
    * ii++;
    * if (ii % SAMPLE_RATE == 0)
    *   Serial.printf("%d\n", millis());
    */

  }

  fft.t2mel( y_data, mel_data );

  switch (CurrentMode) {
    case MODE_OFF:
      fill_solid(physic_leds, N_PIXELS, CRGB::Black);
      break;
    case MODE_ON:
      fill_solid(physic_leds, N_PIXELS, CRGB::White);
      break;
    case MODE_SCROLL:
      effect.visualize_scroll(mel_data, physic_leds);
      break;
    case MODE_ENERGY:
      effect.visualize_energy(mel_data, physic_leds);
      break;
    case MODE_SPECTRUM:
      effect.visualize_spectrum(mel_data, physic_leds);
      break;
    case MODE_RAINBOW:
      static uint8_t gHue = 0;
      fill_rainbow(physic_leds, N_PIXELS, gHue, 7);
      EVERY_N_MILLISECONDS( 20 ) {
        gHue++;
      }
      break;
  }
  FastLED.show();

  static uint32_t oldtime = 0;
  uint16_t touch_value;
  //touch_pad_read(TOUCH_PAD_NUM9, &touch_value);
  static bool buttonval = false;
  if(!digitalRead(35)) {
    delay(1);
    if (!digitalRead(35)) 
      buttonval = true;
  } else
      buttonval = false;
  
  if ((buttonval) && (millis() - oldtime > 1000)) {
    oldtime = millis();
    CurrentMode = PLAYMODE((CurrentMode + 1) % MODE_MAX);
  }
  else if (buttonval)
    oldtime = 0;

  yield();
}
