Yourigh/BrimEffect_ESP32/(commit log)

2020-04-05 first version
    [BrimEff.brd, BrimEff.sch, DCjack_CUI_DEVICES_PJ-002A.step, INMP441_module v4.f3z, INMP441_module_rigid v1.step, IR receiver TSOP v2.f3d, TSOP.SLDPRT, TSOP.STEP]
2020-04-07 3d model update
    [BrimEff.xlsx, DCJack_5.5x2.1_cable.STEP]
2020-04-08 3d print export
    [2PCS_Button actuator bottom v5.stl, Box1 v1.stl, Btn act top v1.stl, Lid v1.stl]
2020-04-24 mic module step
    [BrimEff.brd, BrimEff.sch, INMP441_module v4.step]
