Yourigh/BrimEffect_ESP32/(notices)

Notices in the files:
FW/audio-reactive-led-strip/audio-reactive-led-strip.ino:
This program is free software; you can redistribute it and/or modify
it under the terms of the GNU General Public License as published by
the Free Software Foundation; either version 2 of the License, or
(at your option) any later version.
Mechanical/Sub-models/UARTconn-FTSH-103-01-F-DV.stp:
FILE_NAME( 'p:/temp/worker_65/temp/exporttempdir_3424_33_o9He0/format_0/FTSH-103-01-F-DV.stp', '2020-04-03T12:56:59', ( 'License CC BY-ND 4.0' ), ( 'CADENAS' ), ' ', 'PARTsolutions', ' ' );
parts and their libraries:
SparkFun-Retired: Licensing: Creative Commons ShareAlike 4.0 International - https://creativecommons.org/licenses/by-sa/4.0
microbuilder: This work is placed in the public domain, and may be freely used for commercial and non-commercial work with the following conditions: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
